jcjcjc0705/three_finger_gripper/FEATURES.md

# 功能介紹

三指夾爪能做的事。安裝方式和所有指令見 [README](README.md)。

- [概覽](#概覽)
- [夾取](#夾取)
- [教物品與夾法](#教物品與夾法)
- [安全保護](#安全保護)
- [監看夾爪](#監看夾爪)
- [馬達工具](#馬達工具)
- [串接其他軟體](#串接其他軟體)
- [限制](#限制)

---

## 概覽

| | |
|---|---|
| 手 | 一根拇指和兩根手指，兩根手指還能左右張開（spread），共 8 個關節 |
| 馬達 | 8 顆 Dynamixel XC330-M288-T，接在同一條 1 Mbaud 的 bus 上 |
| 手掌感測器 | 相機（640x480 MJPEG，30 fps）和 VL53L1X TOF 測距（30 Hz） |
| 控制器 | 夾爪上的 ns02501/NT98532 板子。所有夾取邏輯都在板子上，以 micro-ROS 執行 |
| PC | Linux、Docker、ROS 2 Jazzy，透過 Ethernet 連接，負責啟動、顯示和下指令 |
| Control loop | 25 Hz |

| Joint | 拇指 | 食指 | 中指 |
|---|---|---|---|
| Spread | | ±90° | ±90° |
| Proximal | -12.7° 到 72.2° | -28.6° 到 70.9° | -28.6° 到 70.9° |
| Distal | -120° 到 36.9° | -120° 到 36.9° | -120° 到 36.9° |

---

## 夾取

### 六種內建夾法

| 夾法 | 張開寬度 | 適用 |
|---|---|---|
| `tripod` | 約 80 mm | 圓形物體，三個指尖平均分布 |
| `pinch` | 約 70 mm | 食指和中指併攏，對著拇指夾 |
| `wide` | 拇指到手指約 80 mm | 手指分開 |
| `envelop` | 約 190 mm | 大型軟物：手先張大，再包覆 |
| `pinch_wide` | 約 190 mm | 用來夾較厚物體的 pinch |
| `two_finger` | 約 130 mm | 小物：食指對中指，拇指讓開 |

選擇夾法後，手會移到它的張開姿勢（preshape）。也可以用手教新的夾法，見[下方](#用手教新夾法)。

### 兩種閉合方式

- **跟隨物體閉合：** 手會根據 TOF 讀值動作。物體進入手指接觸點前 40 mm 的範圍後，越靠近，手閉得越多，讓手指和物體同時到位。物體停下，手就停下；物體退開或消失，手會重新張開。
- **立即閉合：** 不管 TOF 讀值，預設在 4 秒內閉合。

### 接觸與夾持

關節電流達到電流上限的一半，就算接觸。接觸的關節數足夠時（預設 3 個），手就進入夾持，並以有限的力量維持：flexion 關節的電流上限是 350，spread 關節是 250，最大值是 800。

`release` 會回到 preshape，`stop` 會讓手停在原處。

---

## 教物品與夾法

教過的內容都存在夾爪的板子上，斷電後也會保留。最多可存 32 個物品和 16 個新增夾法。

### 物品

每個物品有名稱、使用的夾法，以及兩項校正：

| 校正 | 做法 | 記下的內容 |
|---|---|---|
| 距離 | 把物體放在手指該碰到的位置，按 `c` | 手指碰到物體時的 TOF 讀值 |
| 接觸 | 接著按 `g` | 碰到物體時手閉合的程度 |

`grasp_tui` 會顯示成 `cup -> pinch  85mm 84%`。之後只要選這個物品，就會套用它的夾法和距離，手會跟隨物體閉合。

新的板子內建 `cup`、`foam`、`bear` 三個物品，都還沒有校正。

### 每種夾法

空手按 `b`，量出手閉合到什麼程度時手指會擋住 TOF。手指擋住 TOF、看不到物體之後，手會依據這個值繼續閉合。

### 用手教新夾法

1. 關掉 torque，手指會變軟。
2. 把手指扳到張開姿勢，儲存。
3. 再扳到閉合姿勢，儲存。
4. 打開 torque（手指不會因此移動），儲存。

每種夾法都可以各自設定電流上限、閉合時間和需要接觸的關節數。超出關節極限、閉合時會自碰撞，或閉合後無法再張開的夾法會被拒絕，並說明原因。

---

## 安全保護

| 情況 | 夾爪的反應 |
|---|---|
| 目標姿勢會讓手指互撞 | 手指在碰撞前停下 |
| 手指被推進無法自行退出的姿勢 | 0.3 秒後所有馬達關閉 torque，要用手把手指分開後才能重新開啟 |
| 馬達因過載、過熱或電氣異常自行停機 | 忽略夾取指令，直到該馬達重新開機並恢復 torque |
| PC 或連線中斷 | 維持夾持、完成正在進行的動作，並自動重新連線 |
| 手指出力達到電流上限 | 停止前進，並維持夾持 |
| 用腳本停止 | 先關閉 torque，再讀回每顆馬達，仍開著的會再關掉 |
| `--dry-run` | 不會開啟 torque，可以在手指不動的情況下試指令 |

每顆馬達的 EEPROM 裡也存有自己的位置限制。

---

## 監看夾爪

| 工具 | 顯示內容 |
|---|---|
| `grasp_tui` | 終端機介面，可監看並操作夾取：phase、grasp、object、閉合程度、TOF 距離，以及每個關節的目標、位置、電流、接觸、torque、溫度、電壓和硬體錯誤。異常會反白標示 |
| Foxglove | 跟著手動作的 3D 模型、相機、TOF、狀態，以及每顆馬達的溫度、電壓和錯誤，有現成的 layout |
| RViz | 3D 模型，可用滑桿調整關節，不需要接硬體 |

相機也可以用指令在板子上存一張 JPEG。

見 README 的 [Grasping](README.md#grasping) 和 [Viewing in Foxglove](README.md#viewing-in-foxglove)。

---

## 馬達工具

夾爪運作時，在 PC 上使用：

| 工具 | 功能 |
|---|---|
| `dxl_cli` | 用位址或名稱讀寫任一暫存器、列出所有暫存器、開關 torque、重新開機單顆馬達、設定新的零點 |
| `dxl_debug` | 8 顆馬達的即時表格，可以逐一 jog 各關節 |

Jog 和夾取一樣會經過自碰撞與關節極限檢查。goal 和 profile 暫存器由 control loop 管理，寫入會被拒絕，ID 和 baud rate 也不能改。寫入 EEPROM 前，要先關閉該馬達的 torque。

夾爪停止時，可以在板子上用 `dxl_offline`、`tof_read`、`camera_capture` 和 `uros_hello` 分別測試馬達、TOF、相機和網路連線。

見 README 的 [Motor debugging](README.md#motor-debugging)。

---

## 串接其他軟體

所有功能都透過 ROS 2 topic 提供，其他軟體可以取代 `grasp_tui` 來操作夾爪。

| Topic | 內容 |
|---|---|
| `/gripper/command` | 文字指令：夾法名稱、`arm`、`grasp`、`release`、`stop`、`calibrate`、`photo` 等 |
| `/gripper/object` | 手前方物體的名稱。不含物體辨識，辨識程式只要把名稱發到這裡 |
| `/gripper/status` | phase、grasp、object、閉合程度、接觸和錯誤，5 Hz |
| `/joint_states`、`/tf` | 手的姿態，25 Hz |
| `/tof/range` | TOF 讀值，30 Hz |
| `/palm_camera/image_raw/compressed` | 相機影像，JPEG |

馬達工具也有對應的 ROS 2 service。完整清單見 README 的 [ROS 2 interface](README.md#ros-2-interface)。

---

## 限制

| 項目 | 限制 |
|---|---|
| 跟隨物體閉合 | 物體速度要在約 12 mm/s 以內，更快的話物體會比手指先到 |
| 板子上的儲存 | 32 個物品、16 個新增夾法 |
| 啟動 | 透過板子的 serial console，所以 USB serial 轉接器要插著 |
| 以電流上限夾持的最長測試時間 | 20 秒 |

其他限制見 README 的 [Known limitations](README.md#known-limitations)。
