jcjcjc0705/three_finger_gripper/src/three_finger_gripper_description/meshes/C_2_Link.stl

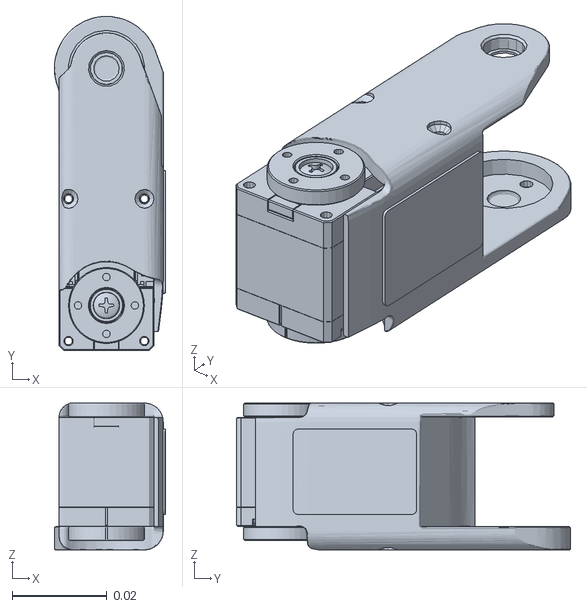
[picture p1: CAD file, 2026-09-07]
src/three_finger_gripper_description/meshes/C_2_Link.stl
0.0235 x 0.0705 x 0.031
