jcjcjc0705/three_finger_gripper/src/three_finger_gripper_description/meshes/B_3_Link.stl

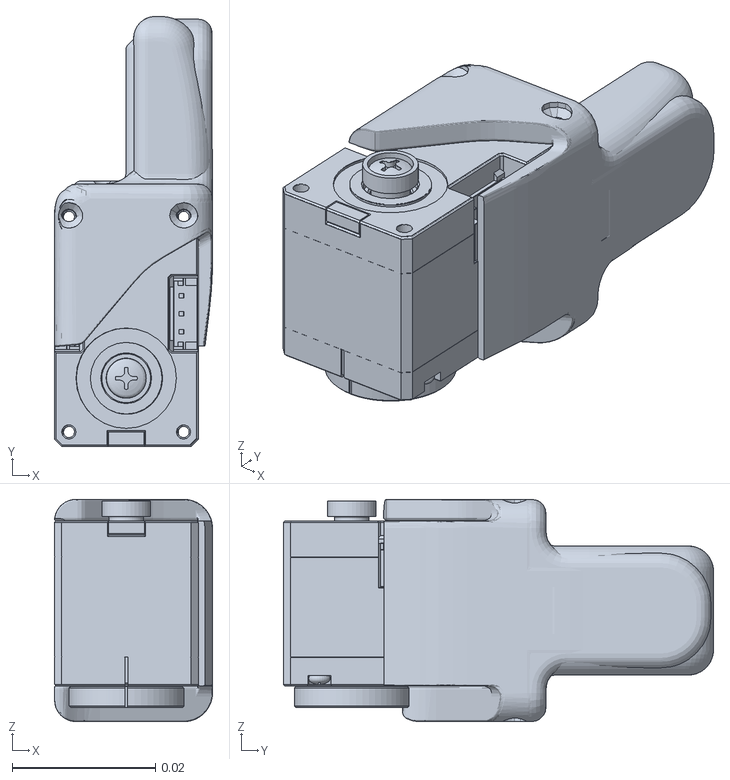
[picture p2: CAD file, 2026-09-07]
src/three_finger_gripper_description/meshes/B_3_Link.stl
0.022 x 0.06 x 0.031
