jcjcjc0705/three_finger_gripper/src/three_finger_gripper_description/meshes/base_link.stl

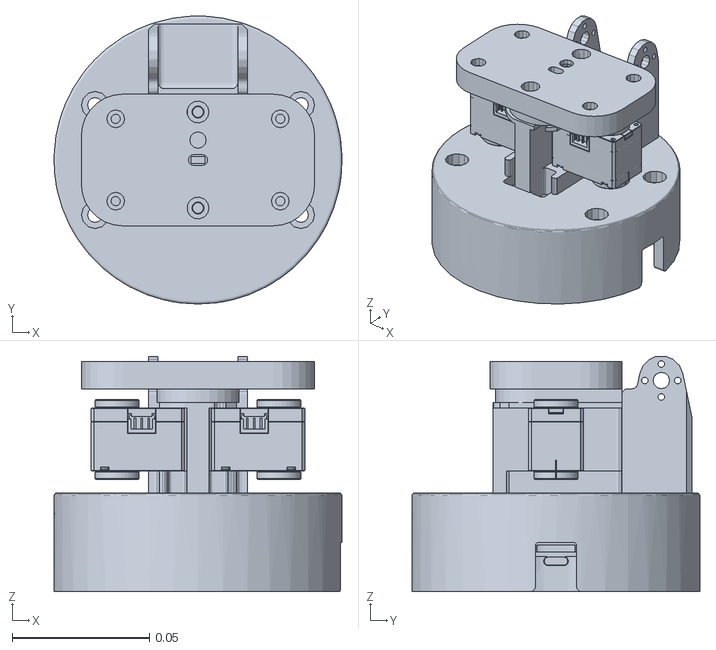
[picture p3: CAD file, 2026-09-07]
src/three_finger_gripper_description/meshes/base_link.stl
0.105 x 0.105 x 0.0858
