jcjcjc0705/three_finger_gripper/src/three_finger_gripper_description/meshes/B_1_Link_001.stl

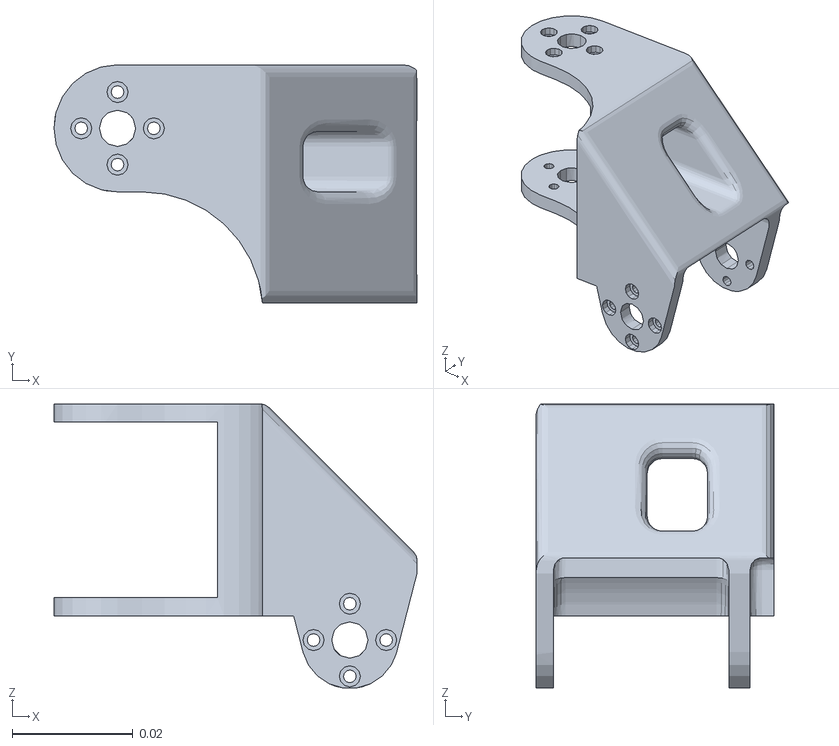
[picture p4: CAD file, 2026-09-07]
src/three_finger_gripper_description/meshes/B_1_Link_001.stl
0.06 x 0.0394 x 0.0469
