jcjcjc0705/three_finger_gripper/(list of files, cad)

Other CAD files:
src/three_finger_gripper_description/meshes/A_2_Link.stl
src/three_finger_gripper_description/meshes/A_1_Link.stl
src/three_finger_gripper_description/meshes/C_3_Link_001.stl
src/three_finger_gripper_description/meshes/A_3_Link.stl
src/three_finger_gripper_description/meshes/B_2_Link.stl
