jcjcjc0705/three_finger_gripper/(commit log)

2026-09-07 Initial commit: three-finger gripper ros2_control system
    Eight XC330 joints driven through ros2_control, with the servo core kept
    free of ROS so it can move to the NT98532 unchanged.
    - dynamixel_msgs / dynamixel_hardware / dynamixel_tools reused unchanged
    from the arm project; nothing in them knows this gripper exists
    - three_finger_gripper_description generated from the CAD by
    tools/usd2urdf.py, verified against the source USD to 0.000 mm
    - gripper_servo: trajectory generation, capsule self-collision along the
    whole path, per-joint current ceilings, and a watchdog that holds both
    position and grip. 27 behaviour checks, no hardware needed
    - gripper_control / gripper_bringup: the Pha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
    [A_1_Link.stl, A_2_Link.stl, A_3_Link.stl, B_1_Link_001.stl, B_2_Link.stl, B_3_Link.stl, C_2_Link.stl, C_3_Link_001.stl]
2026-09-18 Add the palm TOF firmware and how to work on it
    The XIAO's sketch was lost twice: once when entering the bootloader erased
    the app row, and once when the working copy was deleted and only the Arduino
    build cache still held it. Both copies are recovered here, with the binary
    and the pre-erase flash dump.
    firmware/README.md carries what the repo never recorded: the wire protocol,
    the sensor settings, how to flash, and the two traps that cost the most time
    -- that a 1200-baud touch destroys the sketch and cannot be undone by a power
    cycle, and that Wire's write path spins forever on a line held low, so a dead
    I2C bus produces total silence rather than the error the sketch would
    otherwise print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
    [tof_original.ino, tof_vl53l1x.ino]
2026-11-02 Run the gripper on its board under micro-ROS
    Everything on the gripper now runs on the ns02501/NT98532 board: the control
    loop, self-collision protection, grasps, following an object in, motor debugging,
    and objects and grasps kept on NAND. The PC starts it over the serial console,
    bridges it to ROS 2, and shows it in Foxglove and grasp_tui.
    Remove the ros2_control stack, the USB sensor drivers and the CAD generators. Move
    the motor bus and the servo core into firmware_ns02501, which now builds on its
    own with build.sh.
2026-11-03 Keep UROS_ARGS under --dry-run and list the motor topics
